phoyd/avr-teletext/schematic/avr-teletext.pdf

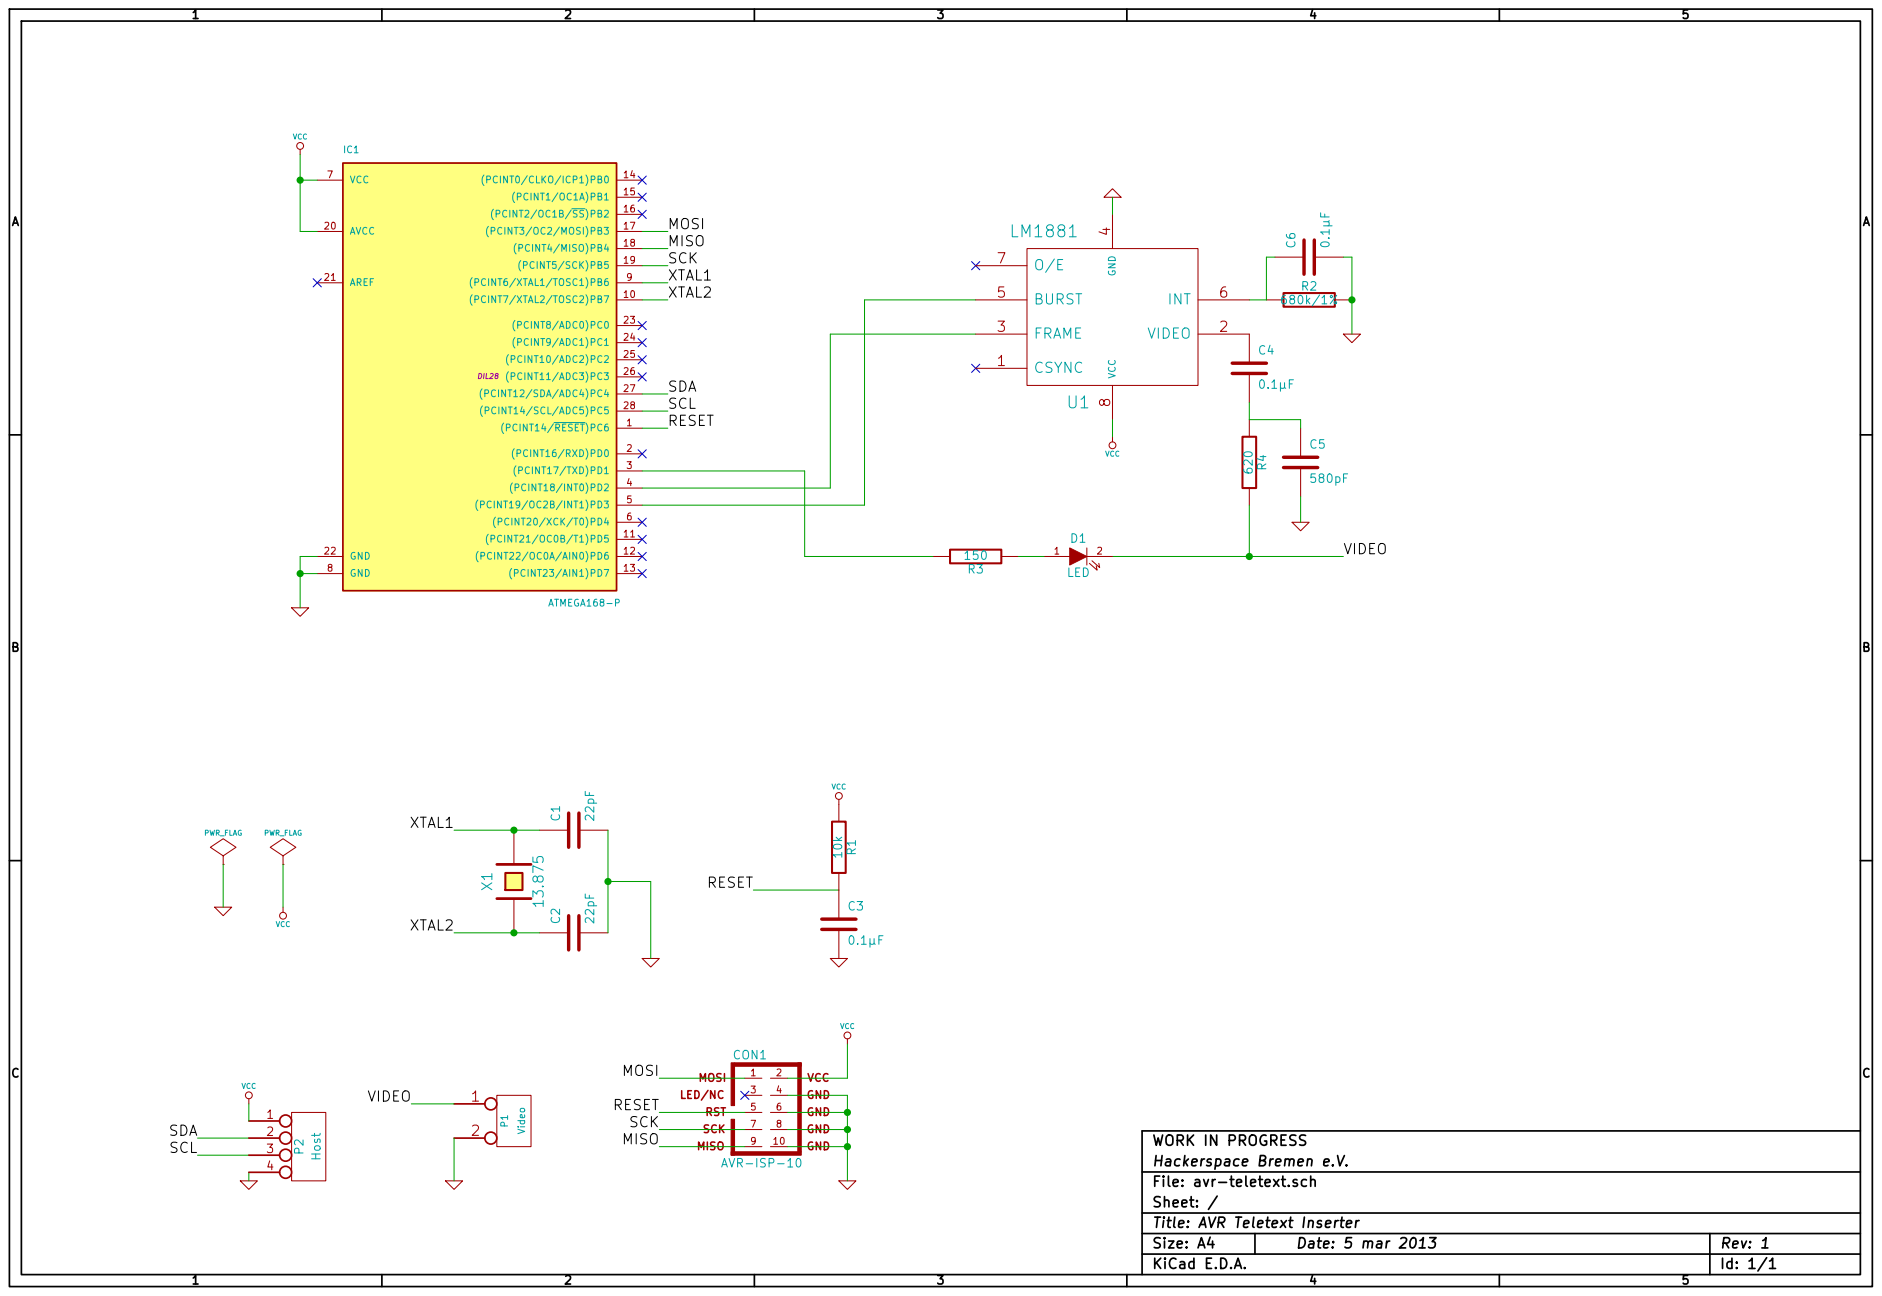
[picture p1: page 1]

VCC GND GND GND

WORK IN PROGRESS
Hackerspace Bremen e.V.
Id: 1/1 Title: AVR Teletext Inserter File: avr-teletext.sch Sheet: /
