phoyd/avr-teletext/schematic/avr-teletext.sch

## KiCad design schematic/avr-teletext.sch (2013-03-05)

Schematic: avr-teletext.sch

Parts:
C1, C2: 22pF
C3, C4, C6: 0.1µF
C5: 580pF
CON1: AVR-ISP-10
D1: LED
IC1: ATMEGA168-P; DIL28
P1: Video
P2: Host
R1: 10k
R2: 680k/1%
R3: 150
R4: 620
U1: LM1881
X1: 13.875
