phoyd/avr-teletext/main.c

/*
    Copyright 2012 Alistair Buxton <a.j.buxton@gmail.com>

    This file is part of avr-teletext.

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
    You should have received a copy of the GNU General Public License
    along with avr-teletext.  If not, see <http://www.gnu.org/licenses/>.
*/

#include <inttypes.h>
#include <avr/io.h>
#include <avr/wdt.h>
#include <avr/interrupt.h>
#include <avr/pgmspace.h>
#include <stdarg.h>
#include <stdlib.h>
#include <stdio.h>

#include "globals.h"

#define WITH_LM1881

#define nop() __asm__ __volatile__("nop\nnop\nnop\nnop");


void io_setup(void)
{

// +---+-----+-----+-----+-----+-----+-----+-----+-----+
// |   |  0  |  1  |  2  |  3  |  4  |  5  |  6  |  7  |
// +---+-----+-----+-----+-----+-----+-----+-----+-----+
// | B | OUT | OUT | OUT | OUT | IN  | IN  |  Crystal  |
// +---+-----+-----+-----+-----+-----+-----+-----+-----+
// | C | OUT | OUT | OUT | OUT | SDA | SCL | RST |  -  |
// +---+-----+-----+-----+-----+-----+-----+-----+-----+
// | D | RXD | TXD |INT0 |INT1 | T0  | T1  | OUT | OUT |
// +---+-----+-----+-----+-----+-----+-----+-----+-----+

  cli();
  // D[7] = shifter enable
  DDRD = 0x12;
  PORTD = 0;

  // SPI setup
  // baud Fosc/2
  UBRR0H = 0;
  UBRR0L = 0;
  // USART0 MSPIM mode, LSB
  UCSR0C = 0xc4;
  // We don't enable TX yet, because it will go high when idle
  // TX is enabled in the ISR during sending.
  UCSR0B = 0;
  
  // enable pull-ups
  DDRC = 0x00;
  PORTC = 0x30;

  // external INT0 and INT1 enable
  EICRA = 0x0b;
  EIMSK = 0x03;

  i2c_setup(); 
  

  sei();

}

volatile uint8_t line_counter;
volatile uint8_t tt_buffer[NBUFFERS][42];
volatile uint8_t buffer_head = 0;
volatile uint8_t buffer_tail = 0;

/* Buffer that we send when we have nothing else to do. */
const uint8_t fill_buffer[42] PROGMEM =
{
  0x49, 0x15, 0x15, 0x15, 0x15, 0x15, 0x15, 0x15,
  0x15, 0x15,
  0x20, 0x20, 0x20, 0x20, 0x20, 0x20, 0x20, 0x20,
  0x20, 0x31, 0xb0, 0xb0, 0x20, 0x54, 0x75, 0xe5,
  0x20, 0x31, 0x37, 0x20, 0x4a, 0x61, 0x6e, 0x83,
  0x32, 0x31, 0xba, 0xb5, 0xb0, 0x2f, 0xb3, 0xb6
};

/* hmm */

extern uint8_t first_row;
extern PROGMEM const char demo_text[];

void run_demo(unsigned n)
{

  while(n-->0)
    {

      int text_pos;
      char c;
      text_pos = 0;
      //console_clear();
      while((c = pgm_read_byte(&(demo_text[text_pos]))) != 0)
        {
          console_putchar(c);
          delay_ms(1);
          text_pos++;
        }
      //delay_s(1);
      console_putchar('\n');
      console_putchar('\n');
    }
}

int tt_putchar(char c, FILE *f)
{
  cli();
  console_putchar(c);
  sei();
  return 0;
}

#ifdef DEBUG
static FILE tt_stdout=FDEV_SETUP_STREAM(tt_putchar, NULL, _FDEV_SETUP_WRITE);
#define SETUP_DEBUG stdout=&tt_stdout
#else
#define SETUP_DEBUG
#endif

int main(void)
{

  SETUP_DEBUG;

  io_setup();
  console_setup();
  run_demo(0);
  console_clear();

  DEBUG_PRINTF("HALLO TELETEXT");

  for(;;)
    {
	i2c_handle();
    } // for

  // Never reached.
  return(0);
}
