phoyd/avr-teletext/(commit log)

2013-03-05 Commit after fork with my inital changes.
    Code has been changed to generate non-inverted teletext,
    allows me to replace the 74ls244n with a LED.
    [main.c]
2013-03-05 Schematic "updated"
2013-03-05 New schematic (KiCad), plus svg for reference.
    [avr-teletext.sch]
2013-03-05 updated with info on schematic
2013-03-05 Fix schematic plot file type
2013-03-05 Added ISP Header Fixed Connection Errors - Passes ERC now.
    [avr-teletext.sch]
2013-03-08 Allow device selection in Makefile
2013-03-08 Added stdio. Output to the console can be done with printf now. Thing freezes/breaks when printf() requires scrolling. Does not seem to happen with delay_ms (like in the demo code). delay_ms does not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
    demotext and teletext styles in extra files.
    [console.c, demotext.c, main.c]
2013-03-11 code cleanup - GNU Style code indentation from now on - Defining DEBUG enables onscreen messages. - single header for C and ASM now. - some fixes
    [console.c, demotext.c, globals.h, main.c, passthrough.c, utils.c]
2013-03-17 changed i2c routine
2013-03-17 assembler fix
